autosportlabs/MegajoltC/Readme.md

Megajolt/C hardware and firmware

Project is incomplete. No support offered - github issues will be ignored. 

Please see LICENSE file for license details
