autosportlabs/MegajoltC/hardware/trunk/mjc_pinmux.xls

Megajolt/C Pinmux
Groups | MJ Function | XMC Pin# | XMC Pin Name | XMC Pin Function
Coils
 | GPO_COIL1 |  | P0.0 | GPIO
 | GPO_COIL2 |  | P0.1 | GPIO
 | GPO_COIL3 |  | P0.2 | GPIO
 | GPO_COIL4 |  | P0.3 | GPIO
 | GPO_COIL5 |  | P0.4 | GPIO
 | GPO_COIL6 |  | P0.5 | GPIO
 | GPO_COIL7 |  | P0.6 | GPIO
 | GPO_COIL8 |  | P0.7 | GPIO
 | GPO_COIL_EN |  | P0.8 | GPIO
ADC Inputs
 | CLT_ADC |  | P14.0 | VADC_G0CH0
 | IAT_ADC |  | P14.4 | VADC_G0CH4
 | TPS_ADC |  | P14.5 | VADC_G0CH5
 | VBATT_ADC |  | P14.6 | VADC_G0CH6
 | AUX_ADC
Communication
 | FTDI_TXD |  | P1.4 | U0C0.DX0B
 | FTDI_RXD |  | P1.5 | U0C0.DOUT0
 | ESP_TXD |  | P2.5 | U0C1.DOUT0
 | ESP_RXD |  | P2.2 | U0C1.DX0A
 | CAN_TX |  | P2.7 | CAN.N1_TXDC1
 | CAN_RX |  | P2.6 | CAN.N1_RXDCA1
 | EEPROM_SDA |  | P0.4 | U1C0.DX0A
 | EEPROM_SCL |  | P0.11 | U1C0_SCLKOUT
Misc Outputs
 | PGM_GPO |  | P2.3 | GPIO
 | TACH_GPO |  | P2.4 | GPIO
 | STATUS_LED1 |  | P14.8 | GPIO
 | STATUS_LED2 |  | P14.9 | GPIO
