autosportlabs/MegajoltC/tools/trigger_wheel_rotary_simulator/trigger_wheel.stl

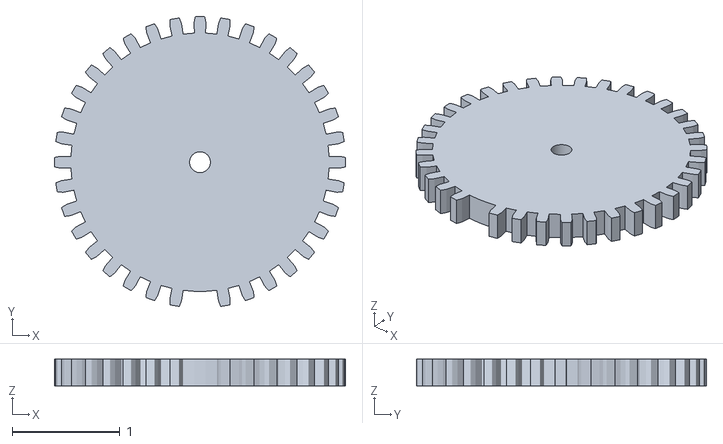
[picture p1: CAD file, 2012-10-20]
tools/trigger_wheel_rotary_simulator/trigger_wheel.stl
2.70 x 2.69 x 0.25
