autosportlabs/MegajoltC/tools/trigger_wheel_rotary_simulator/trigger_wheel_plate.stl

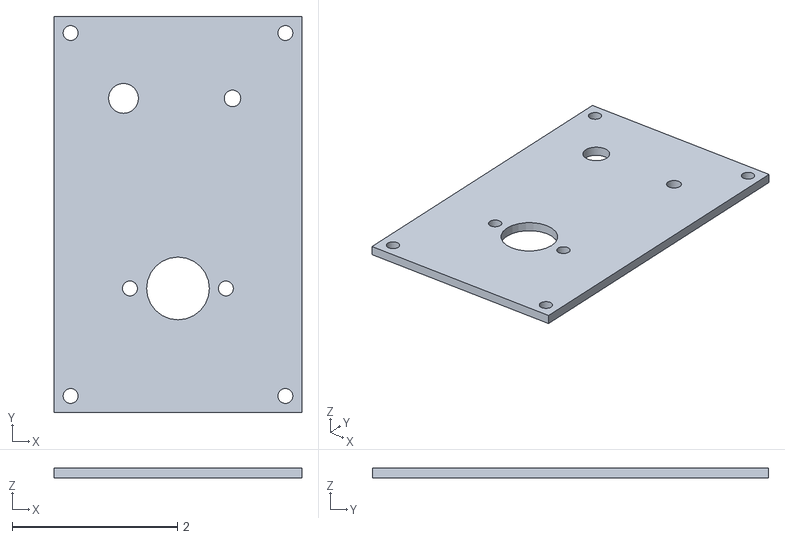
[picture p2: CAD file, 2012-10-20]
tools/trigger_wheel_rotary_simulator/trigger_wheel_plate.stl
3.00 x 4.79 x 0.125
