autosportlabs/MegajoltC/(list of files, cad)

Other CAD files:
tools/trigger_wheel_rotary_simulator/trigger_wheel.skp
tools/trigger_wheel_rotary_simulator/trigger_wheel_plate.skp
