autosportlabs/MegajoltC/hardware/trunk/megajoltC.brd

## EAGLE design hardware/trunk/megajoltC.brd (2015-04-11)

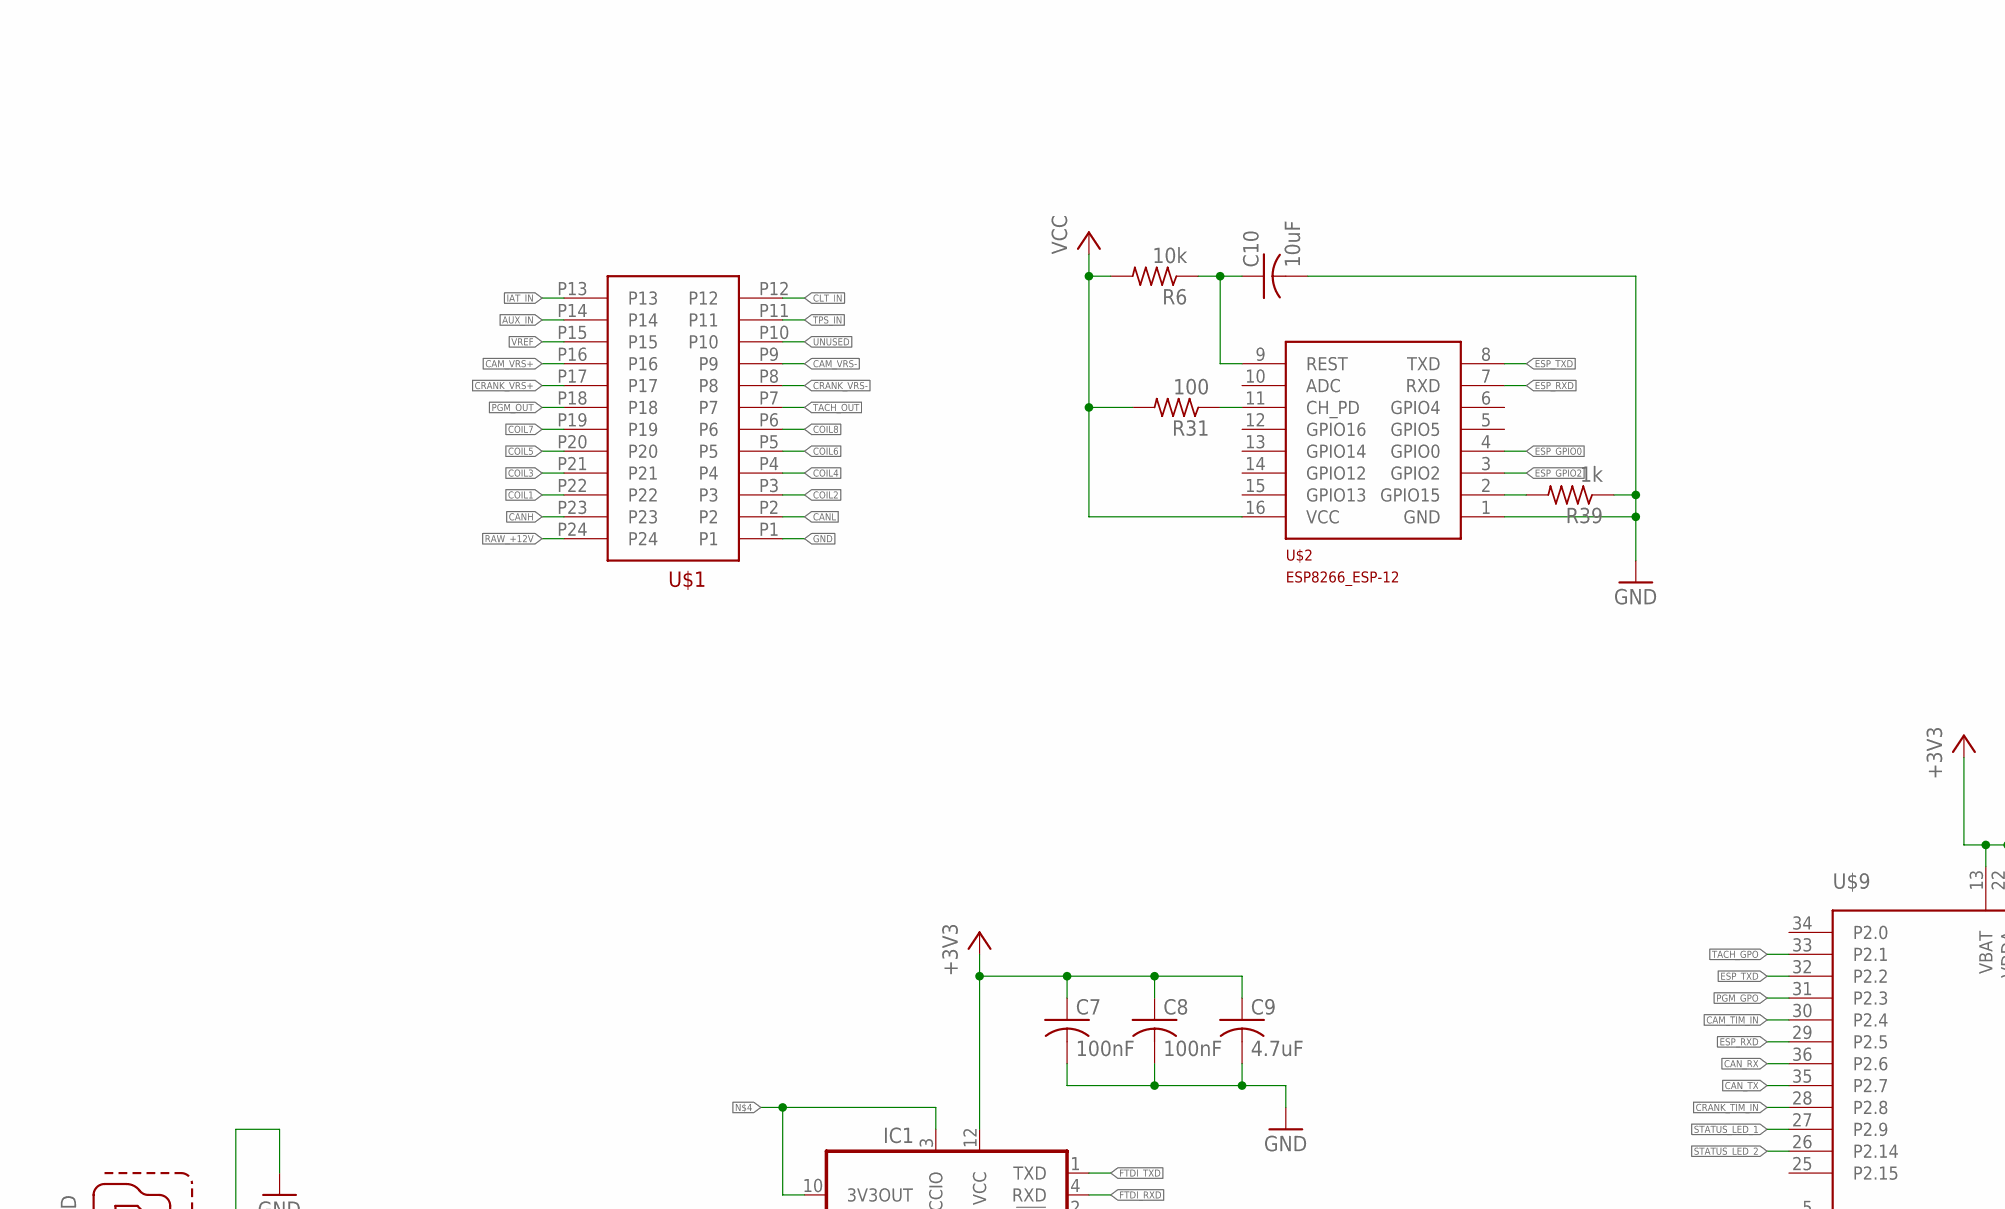
[picture p3: schematic megajoltC.sch, sheet 1, part in row 1, column 1]

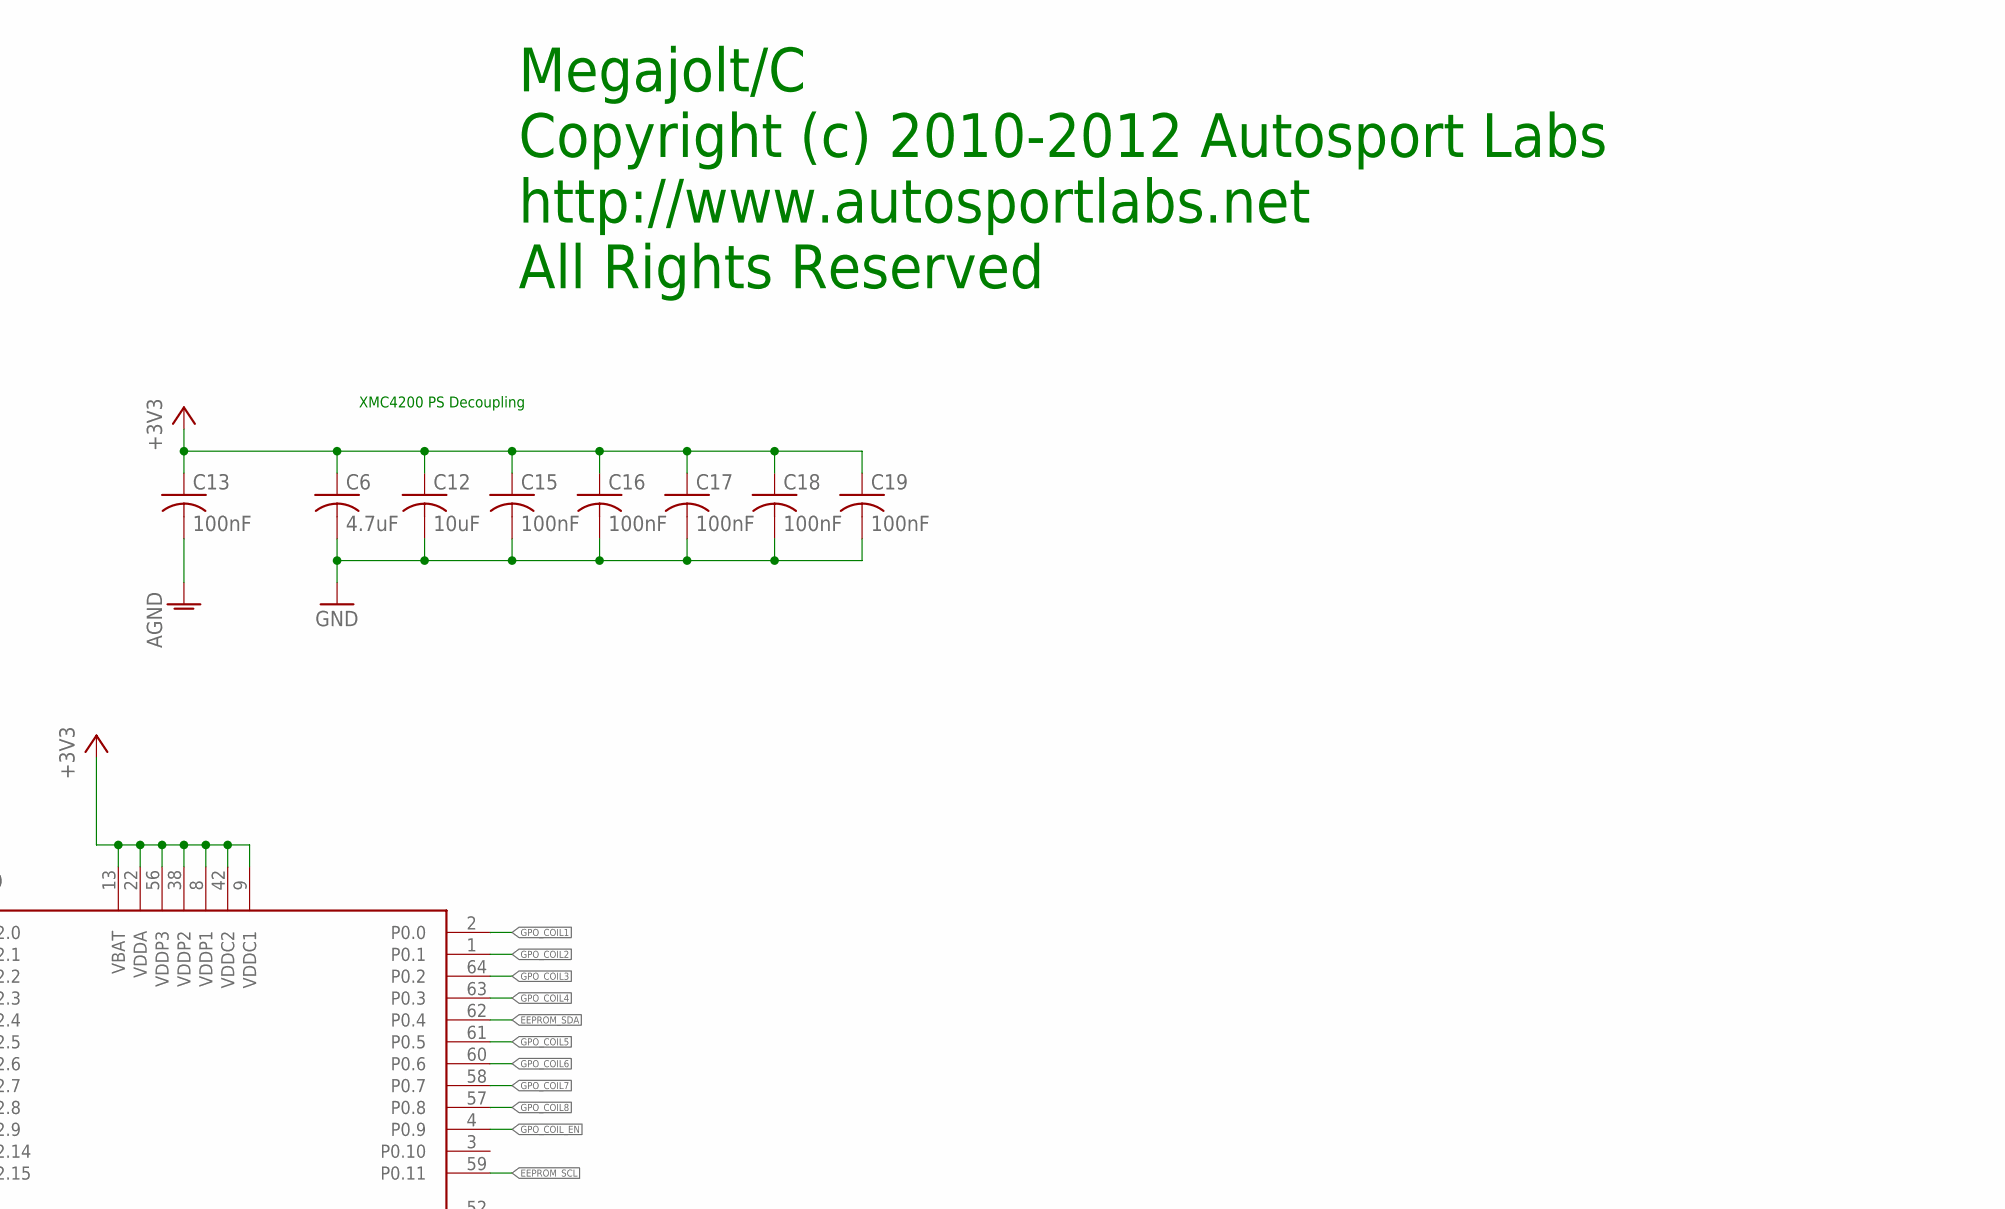
[picture p4: schematic megajoltC.sch, sheet 1, part in row 1, column 2]

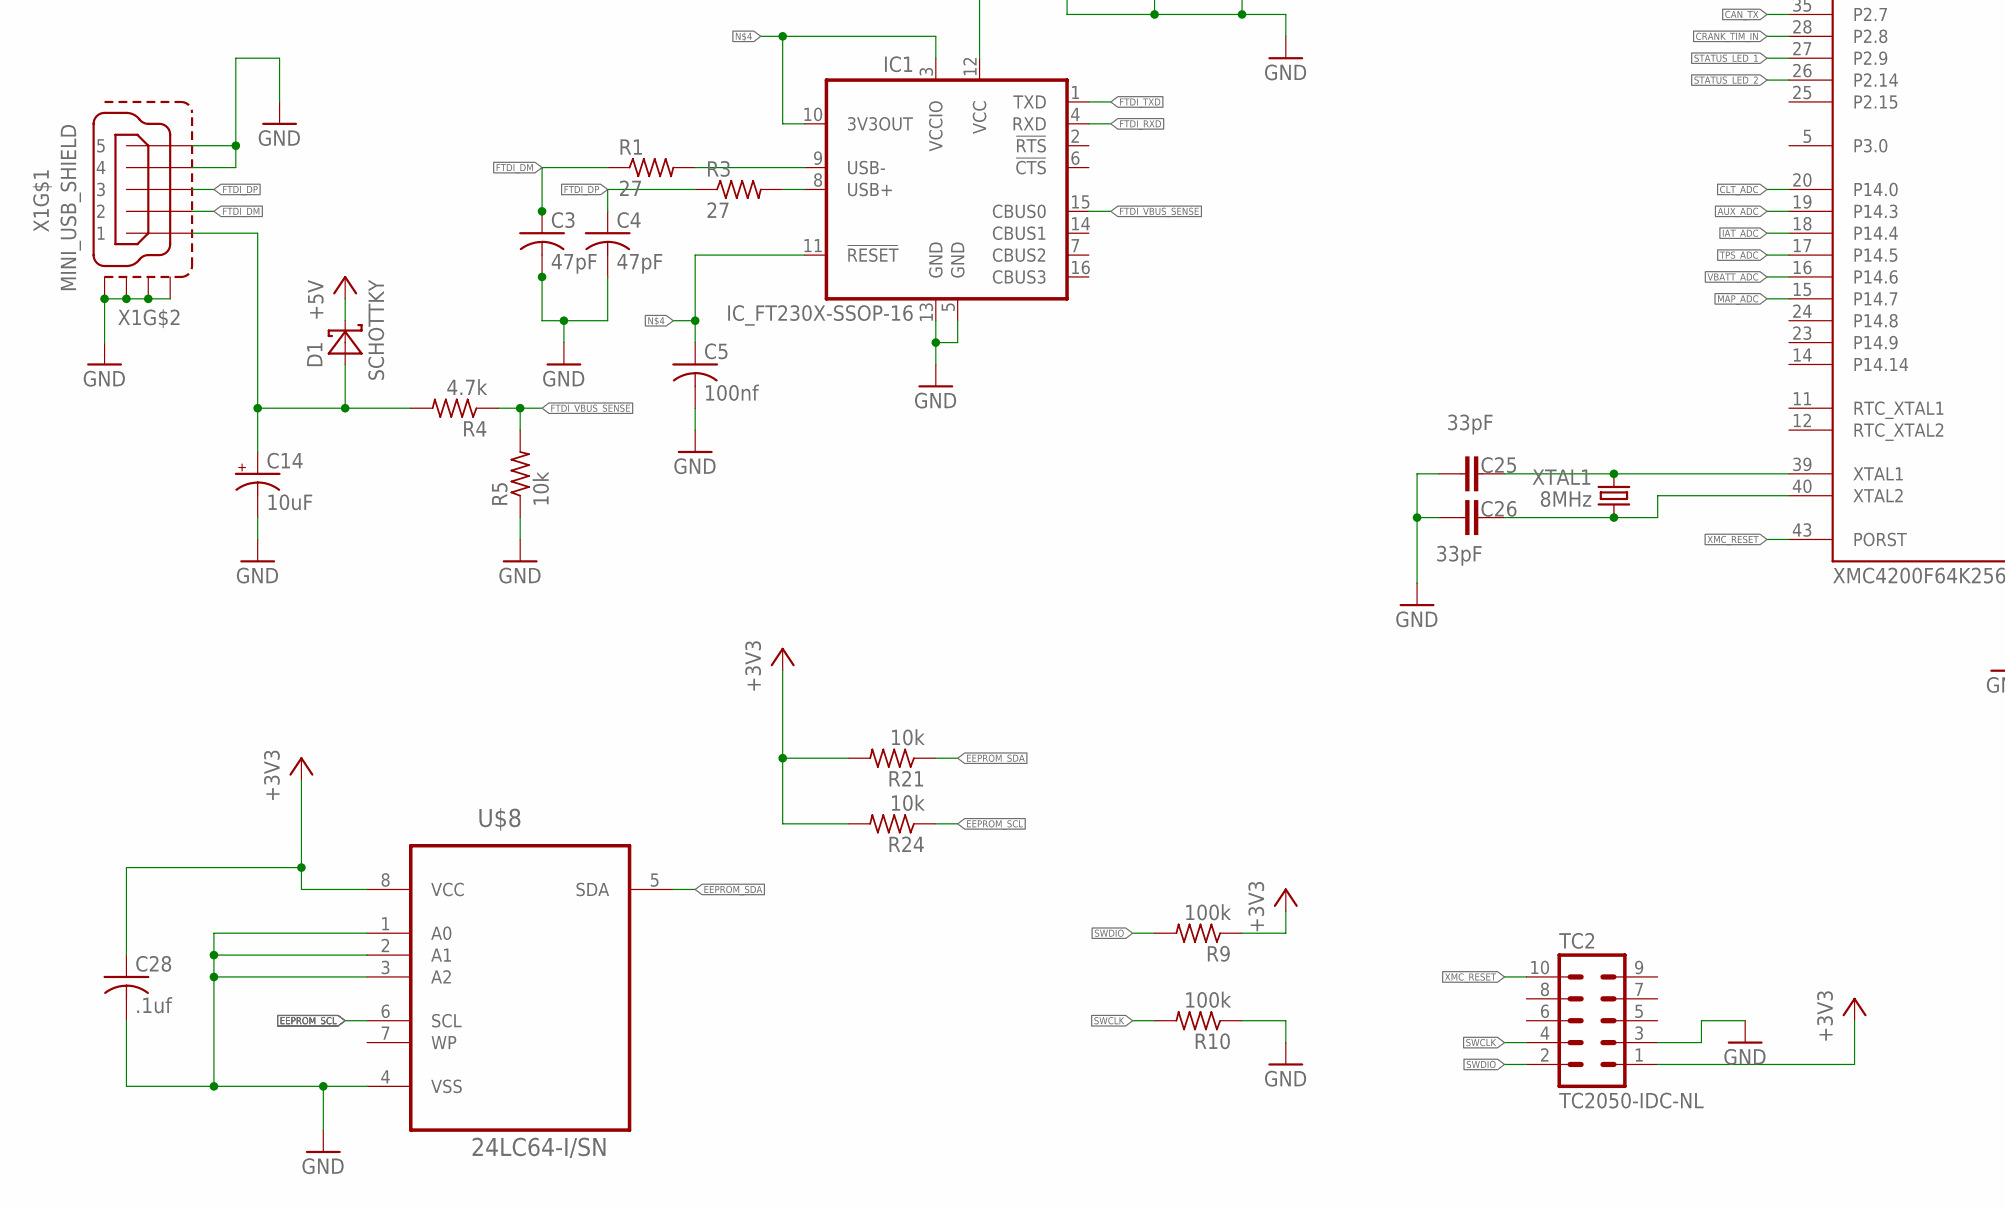
[picture p5: schematic megajoltC.sch, sheet 1, part in row 2, column 1]

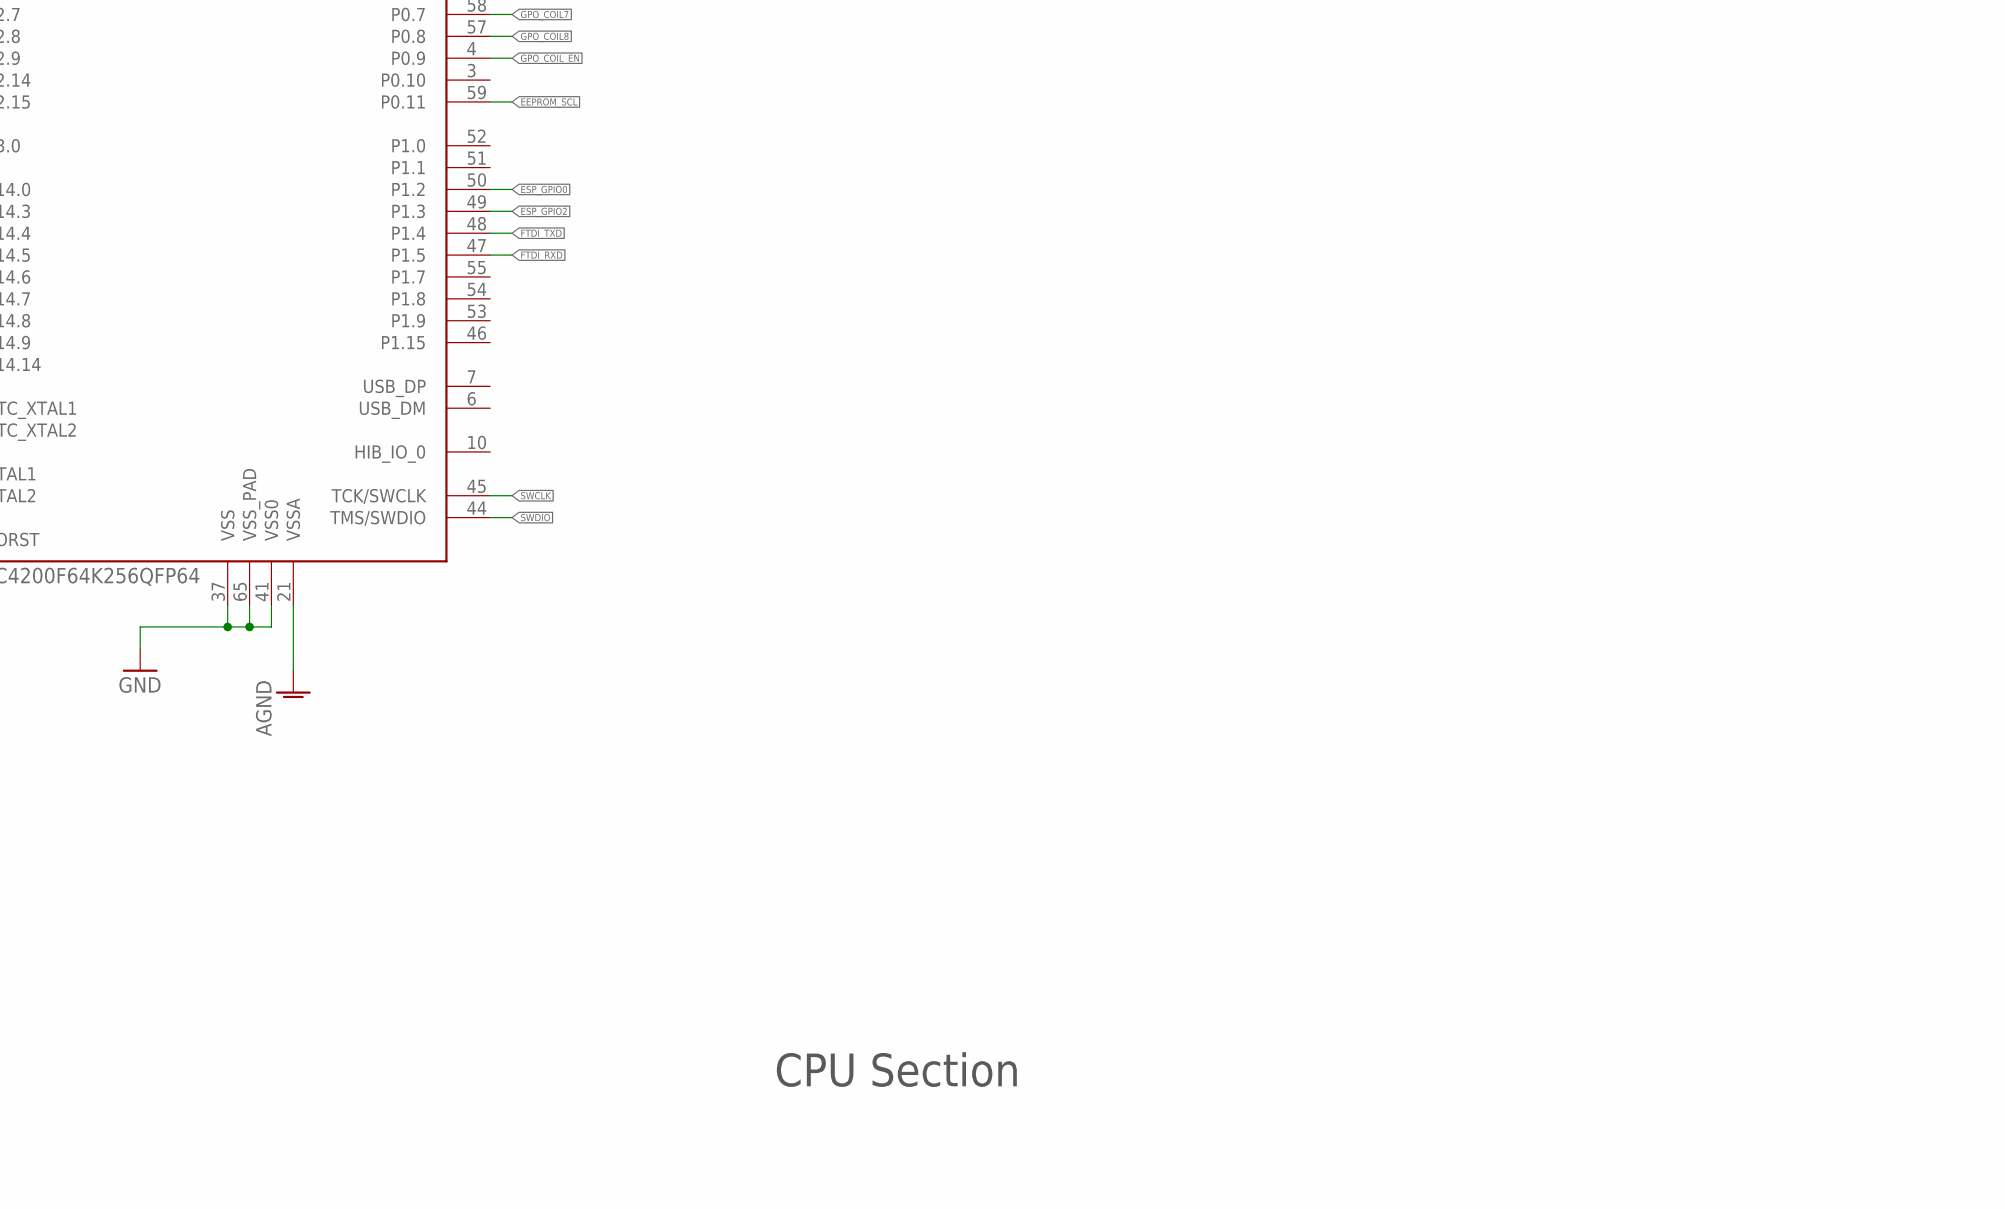
[picture p6: schematic megajoltC.sch, sheet 1, part in row 2, column 2]

Parts:
C3, C4: 47pF; C0603
C5: 100nf; C0603
C6, C9: 4.7uF; C0603
C7, C8, C13, C15, C16, C17, C18, C19: 100nF; C0603
C10, C12: 10uF; C0603
C14: 10uF; SMC_A
C25, C26: 33pF; 0603
C28: .1uf; C0603
D1: SCHOTTKY; SMA
IC1: IC_FT230X-SSOP-16; SSOP-16-FTDI
R1, R3: 27; R0603
R4: 4.7k; R0603
R5, R6, R21, R24: 10k; R0603
R9, R10: 100k; R0603
R31: 100; R0603
R39: 1k; R0603
TC2: TC2050-IDC-NL
U$1: MOLEX_MINIFIT-JR-24
U$2: ESP8266_ESP-12; ESP8266-ESP12
U$8: 24LC64-I/SN; SOIC127P600X175-8N
U$9: XMC4200F64K256QFP64; INF-PG-LQFP-64-5800X5800T28
X1: MINI_USB_SHIELD; MINI-USB_JACK
XTAL1: 8MHz; CRYSTAL-SMD-5X3

Connections:
+3V3: C6.1, C7.1, C8.1, C9.1, C12.1, C13.1, C15.1, C16.1, C17.1, C18.1, C19.1, C28.1, IC1.12 (VCC), R9.1, R21.2, R24.2, TC2.1, U$8.8 (VCC), U$9.8 (VDDP1), U$9.9 (VDDC1), U$9.13 (VBAT), U$9.22 (VDDA), U$9.38 (VDDP2), U$9.42 (VDDC2), U$9.56 (VDDP3); also elsewhere on the board
+5V: D1.C; also elsewhere on the board
AGND: C13.2, U$9.21 (VSSA); also elsewhere on the board
AUX_ADC: U$9.19 (P14.3); also elsewhere on the board
AUX_IN: U$1.P14; also elsewhere on the board
CAM_TIM_IN: U$9.30 (P2.4); also elsewhere on the board
CAM_VRS+: U$1.P16; also elsewhere on the board
CAM_VRS-: U$1.P9; also elsewhere on the board
CANH: U$1.P23; also elsewhere on the board
CANL: U$1.P2; also elsewhere on the board
CAN_RX: U$9.36 (P2.6); also elsewhere on the board
CAN_TX: U$9.35 (P2.7); also elsewhere on the board
CLT_ADC: U$9.20 (P14.0); also elsewhere on the board
CLT_IN: U$1.P12; also elsewhere on the board
COIL1: U$1.P22; also elsewhere on the board
COIL2: U$1.P3; also elsewhere on the board
COIL3: U$1.P21; also elsewhere on the board
COIL4: U$1.P4; also elsewhere on the board
COIL5: U$1.P20; also elsewhere on the board
COIL6: U$1.P5; also elsewhere on the board
COIL7: U$1.P19; also elsewhere on the board
COIL8: U$1.P6; also elsewhere on the board
CRANK_TIM_IN: U$9.28 (P2.8); also elsewhere on the board
CRANK_VRS+: U$1.P17; also elsewhere on the board
CRANK_VRS-: U$1.P8; also elsewhere on the board
EEPROM_SCL: R24.1, U$8.6 (SCL), U$9.59 (P0.11)
EEPROM_SDA: R21.1, U$8.5 (SDA), U$9.62 (P0.4)
ESP_GPIO0: U$2.4 (GPIO0), U$9.50 (P1.2)
ESP_GPIO2: U$2.3 (GPIO2), U$9.49 (P1.3)
ESP_RXD: U$2.7 (RXD), U$9.29 (P2.5)
ESP_TXD: U$2.8 (TXD), U$9.32 (P2.2)
FTDI_DM: C3.1, R1.1, X1.2
FTDI_DP: C4.1, R3.1, X1.3
FTDI_RXD: IC1.4 (RXD), U$9.47 (P1.5)
FTDI_TXD: IC1.1 (TXD), U$9.48 (P1.4)
FTDI_VBUS_SENSE: IC1.15 (CBUS0), R4.1, R5.2
GND: C3.2, C4.2, C5.2, C6.2, C7.2, C8.2, C9.2, C10.2, C12.2, C14.-, C15.2, C16.2, C17.2, C18.2, C19.2, C25.1, C26.1, C28.2, IC1.5 (GND), IC1.13 (GND), R5.1, R10.1, R39.1, TC2.3, U$1.P1, U$2.1 (GND), U$8.1 (A0), U$8.2 (A1), U$8.3 (A2), U$8.4 (VSS), U$9.37 (VSS), U$9.41 (VSS0), U$9.65 (VSS_PAD), X1.4, X1.5, X1.M1 (S1), X1.M2 (S2), X1.M3 (S3), X1.M4 (S4); also elsewhere on the board
GPO_COIL1: U$9.2 (P0.0); also elsewhere on the board
GPO_COIL2: U$9.1 (P0.1); also elsewhere on the board
GPO_COIL3: U$9.64 (P0.2); also elsewhere on the board
GPO_COIL4: U$9.63 (P0.3); also elsewhere on the board
GPO_COIL5: U$9.61 (P0.5); also elsewhere on the board
GPO_COIL6: U$9.60 (P0.6); also elsewhere on the board
GPO_COIL7: U$9.58 (P0.7); also elsewhere on the board
GPO_COIL8: U$9.57 (P0.8); also elsewhere on the board
GPO_COIL_EN: U$9.4 (P0.9); also elsewhere on the board
IAT_ADC: U$9.18 (P14.4); also elsewhere on the board
IAT_IN: U$1.P13; also elsewhere on the board
MAP_ADC: U$9.15 (P14.7); also elsewhere on the board
unnamed: IC1.8 (USB+), R3.2
unnamed: IC1.9 (USB-), R1.2
unnamed: C5.1, IC1.3 (VCCIO), IC1.10 (3V3OUT), IC1.11 (!RESET)
unnamed: C10.1, R6.1, U$2.9 (REST)
unnamed: R31.1, U$2.11 (CH_PD)
unnamed: C26.2, U$9.40 (XTAL2), XTAL1.1
unnamed: R39.2, U$2.2 (GPIO15)
unnamed: C25.2, U$9.39 (XTAL1), XTAL1.3 (2)
PGM_GPO: U$9.31 (P2.3); also elsewhere on the board
PGM_OUT: U$1.P18; also elsewhere on the board
RAW_+12V: U$1.P24; also elsewhere on the board
STATUS_LED_1: U$9.27 (P2.9); also elsewhere on the board
STATUS_LED_2: U$9.26 (P2.14); also elsewhere on the board
SWCLK: R10.2, TC2.4, U$9.45 (TCK/SWCLK)
SWDIO: R9.2, TC2.2, U$9.44 (TMS/SWDIO)
TACH_GPO: U$9.33 (P2.1); also elsewhere on the board
TACH_OUT: U$1.P7; also elsewhere on the board
TPS_ADC: U$9.17 (P14.5); also elsewhere on the board
TPS_IN: U$1.P11; also elsewhere on the board
UNUSED: U$1.P10
VBATT_ADC: U$9.16 (P14.6); also elsewhere on the board
VBUS: C14.+, D1.A, R4.2, X1.1
VCC: R6.2, R31.2, U$2.16 (VCC); also elsewhere on the board
VREF: U$1.P15; also elsewhere on the board
XMC_RESET: TC2.10, U$9.43 (PORST)

Notes on the sheet:
Megajolt/C
Copyright (c) 2010-2012 Autosport Labs
http://www.autosportlabs.net
All Rights Reserved
CPU Section
XMC4200 PS Decoupling

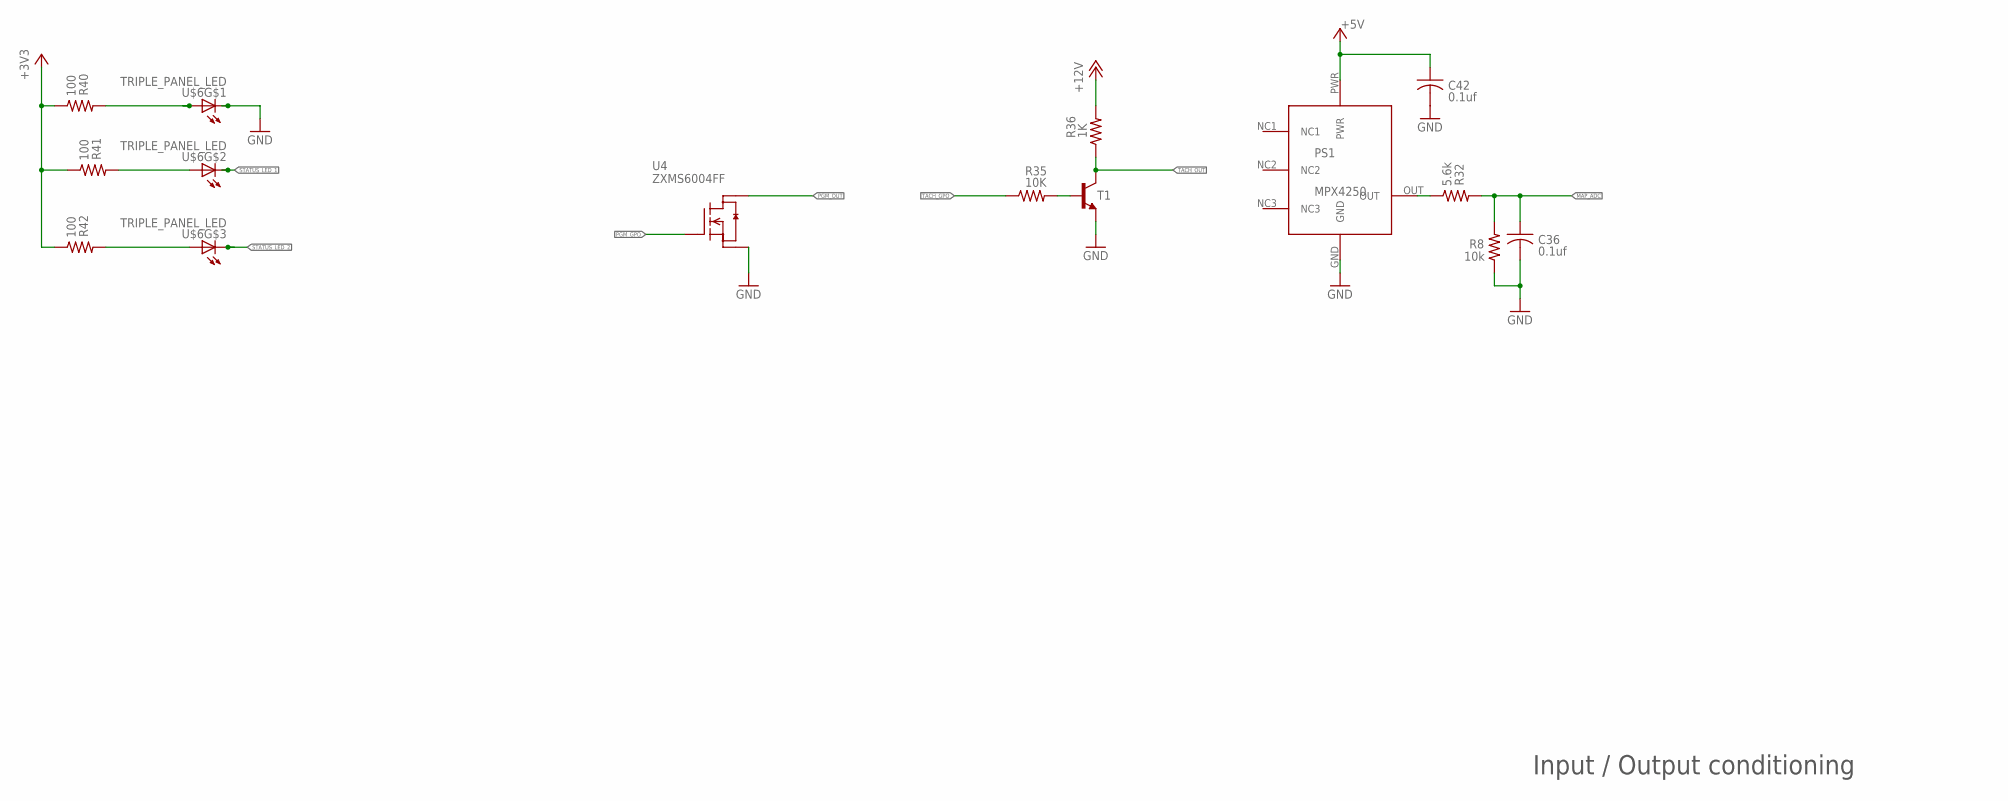
[picture p7: schematic megajoltC.sch, sheet 2]

Parts:
C36, C42: 0.1uf; C0603
PS1: MPX4250
R8: 10k; R0603
R32: 5.6k; R0603
R35: 10K; R0603
R36: 1K; R0603
R40, R41, R42: 100; R0603
T1: -NPN-SOT23-EBC; SOT23-EBC
U4: ZXMS6004FF; SOT-23
U$6: TRIPLE_PANEL_LED; RIGHT_ANGLE_3_LEDS_DEEP

Connections:
+3V3: R40.1, R41.1, R42.1; also elsewhere on the board
+5V: C42.1, PS1.PWR; also elsewhere on the board
GND: C36.2, C42.2, PS1.GND, R8.1, T1.E, U4.2 (S1), U$6.2 (C); also elsewhere on the board
MAP_ADC: C36.1, R8.2, R32.2; also elsewhere on the board
unnamed: PS1.OUT, R32.1
unnamed: R35.2, T1.B
unnamed: R40.2, U$6.1 (A)
unnamed: R41.2, U$6.3 (A)
unnamed: R42.2, U$6.5 (A)
NC1: PS1.NC1
NC2: PS1.NC2
NC3: PS1.NC3
PGM_GPO: U4.1 (G); also elsewhere on the board
PGM_OUT: U4.3 (D1); also elsewhere on the board
SAFE_+12V: R36.2; also elsewhere on the board
STATUS_LED_1: U$6.4 (C); also elsewhere on the board
STATUS_LED_2: U$6.6 (C); also elsewhere on the board
TACH_GPO: R35.1; also elsewhere on the board
TACH_OUT: R36.1, T1.C; also elsewhere on the board

Notes on the sheet:
Input / Output conditioning

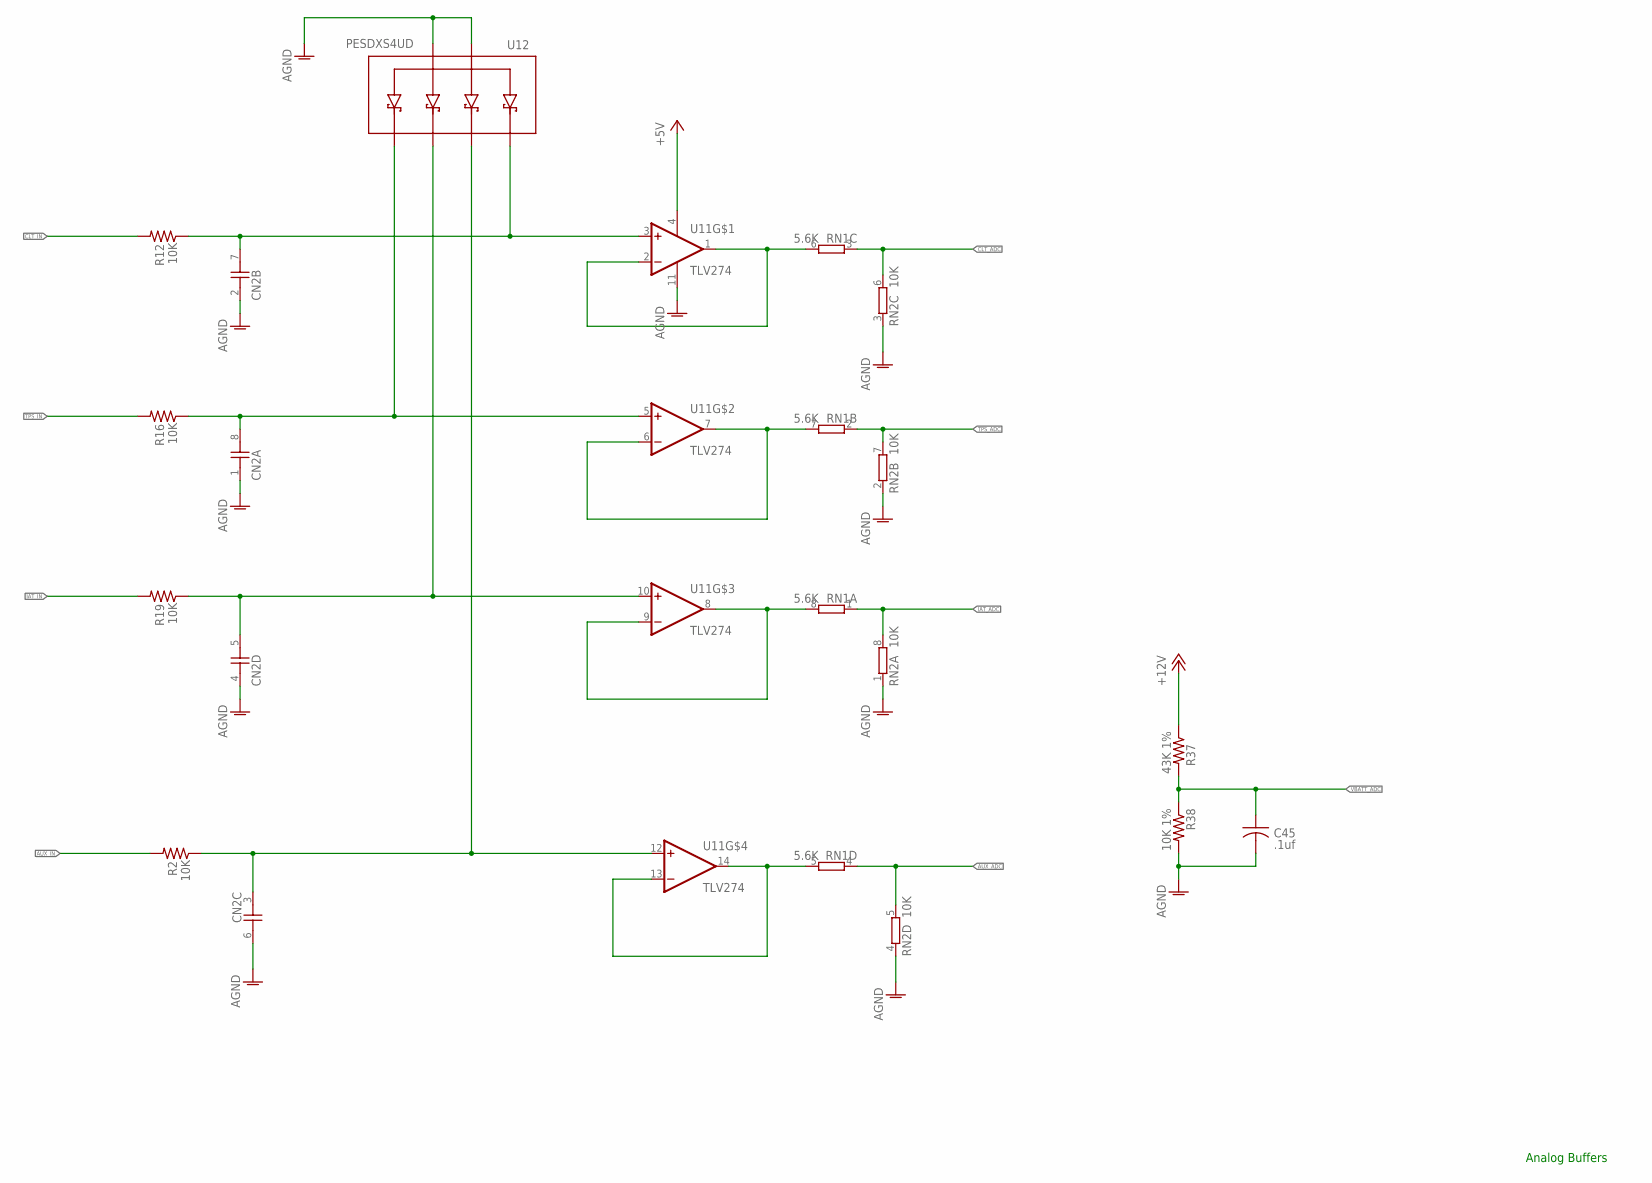
[picture p8: schematic megajoltC.sch, sheet 3]

Parts:
C45: .1uf; C0603
CN2: CAP_ARRAY_41206_ARRAY; 1206_ARRAY
R2, R12, R16, R19: 10K; R1206
R37: 43K 1%; R0603
R38: 10K 1%; R0603
RN1: 5.6K; 0603-ARC
RN2: 10K; 0603-ARC
U11: TLV274; SO14
U12: PESDXS4UD; SC-74

Connections:
+5V: U11.4 (V+); also elsewhere on the board
AGND: C45.2, CN2.1, CN2.2 (1), CN2.4 (1), CN2.6 (2), R38.2, RN2.1, RN2.2 (1), RN2.3 (1), RN2.4 (1), U11.11 (V-), U12.2, U12.5; also elsewhere on the board
ANALOG-FREQ_1_OPAMP_OUT1: RN1.6 (2), U11.1 (OUT), U11.2 (-IN)
ANALOG-FREQ_1_OPAMP_OUT2: RN1.7 (2), U11.6 (-IN), U11.7 (OUT)
ANALOG-FREQ_1_OPAMP_OUT3: RN1.8 (2), U11.8 (OUT), U11.9 (-IN)
AUX_ADC: RN1.4 (1), RN2.5 (2); also elsewhere on the board
AUX_IN: R2.2; also elsewhere on the board
CLT_ADC: RN1.3 (1), RN2.6 (2); also elsewhere on the board
CLT_IN: R12.2; also elsewhere on the board
IAT_ADC: RN1.1, RN2.8 (2); also elsewhere on the board
IAT_IN: R19.2; also elsewhere on the board
unnamed: RN1.5 (2), U11.13 (-IN), U11.14 (OUT)
unnamed: CN2.7 (2), R12.1, U11.3 (+IN), U12.1
unnamed: CN2.8 (2), R16.1, U11.5 (+IN), U12.6
unnamed: CN2.5 (2), R19.1, U11.10 (+IN), U12.4
unnamed: CN2.3 (1), R2.1, U11.12 (+IN), U12.3
SAFE_+12V: R37.1; also elsewhere on the board
TPS_ADC: RN1.2 (1), RN2.7 (2); also elsewhere on the board
TPS_IN: R16.2; also elsewhere on the board
VBATT_ADC: C45.1, R37.2, R38.1; also elsewhere on the board

Notes on the sheet:
Analog Buffers

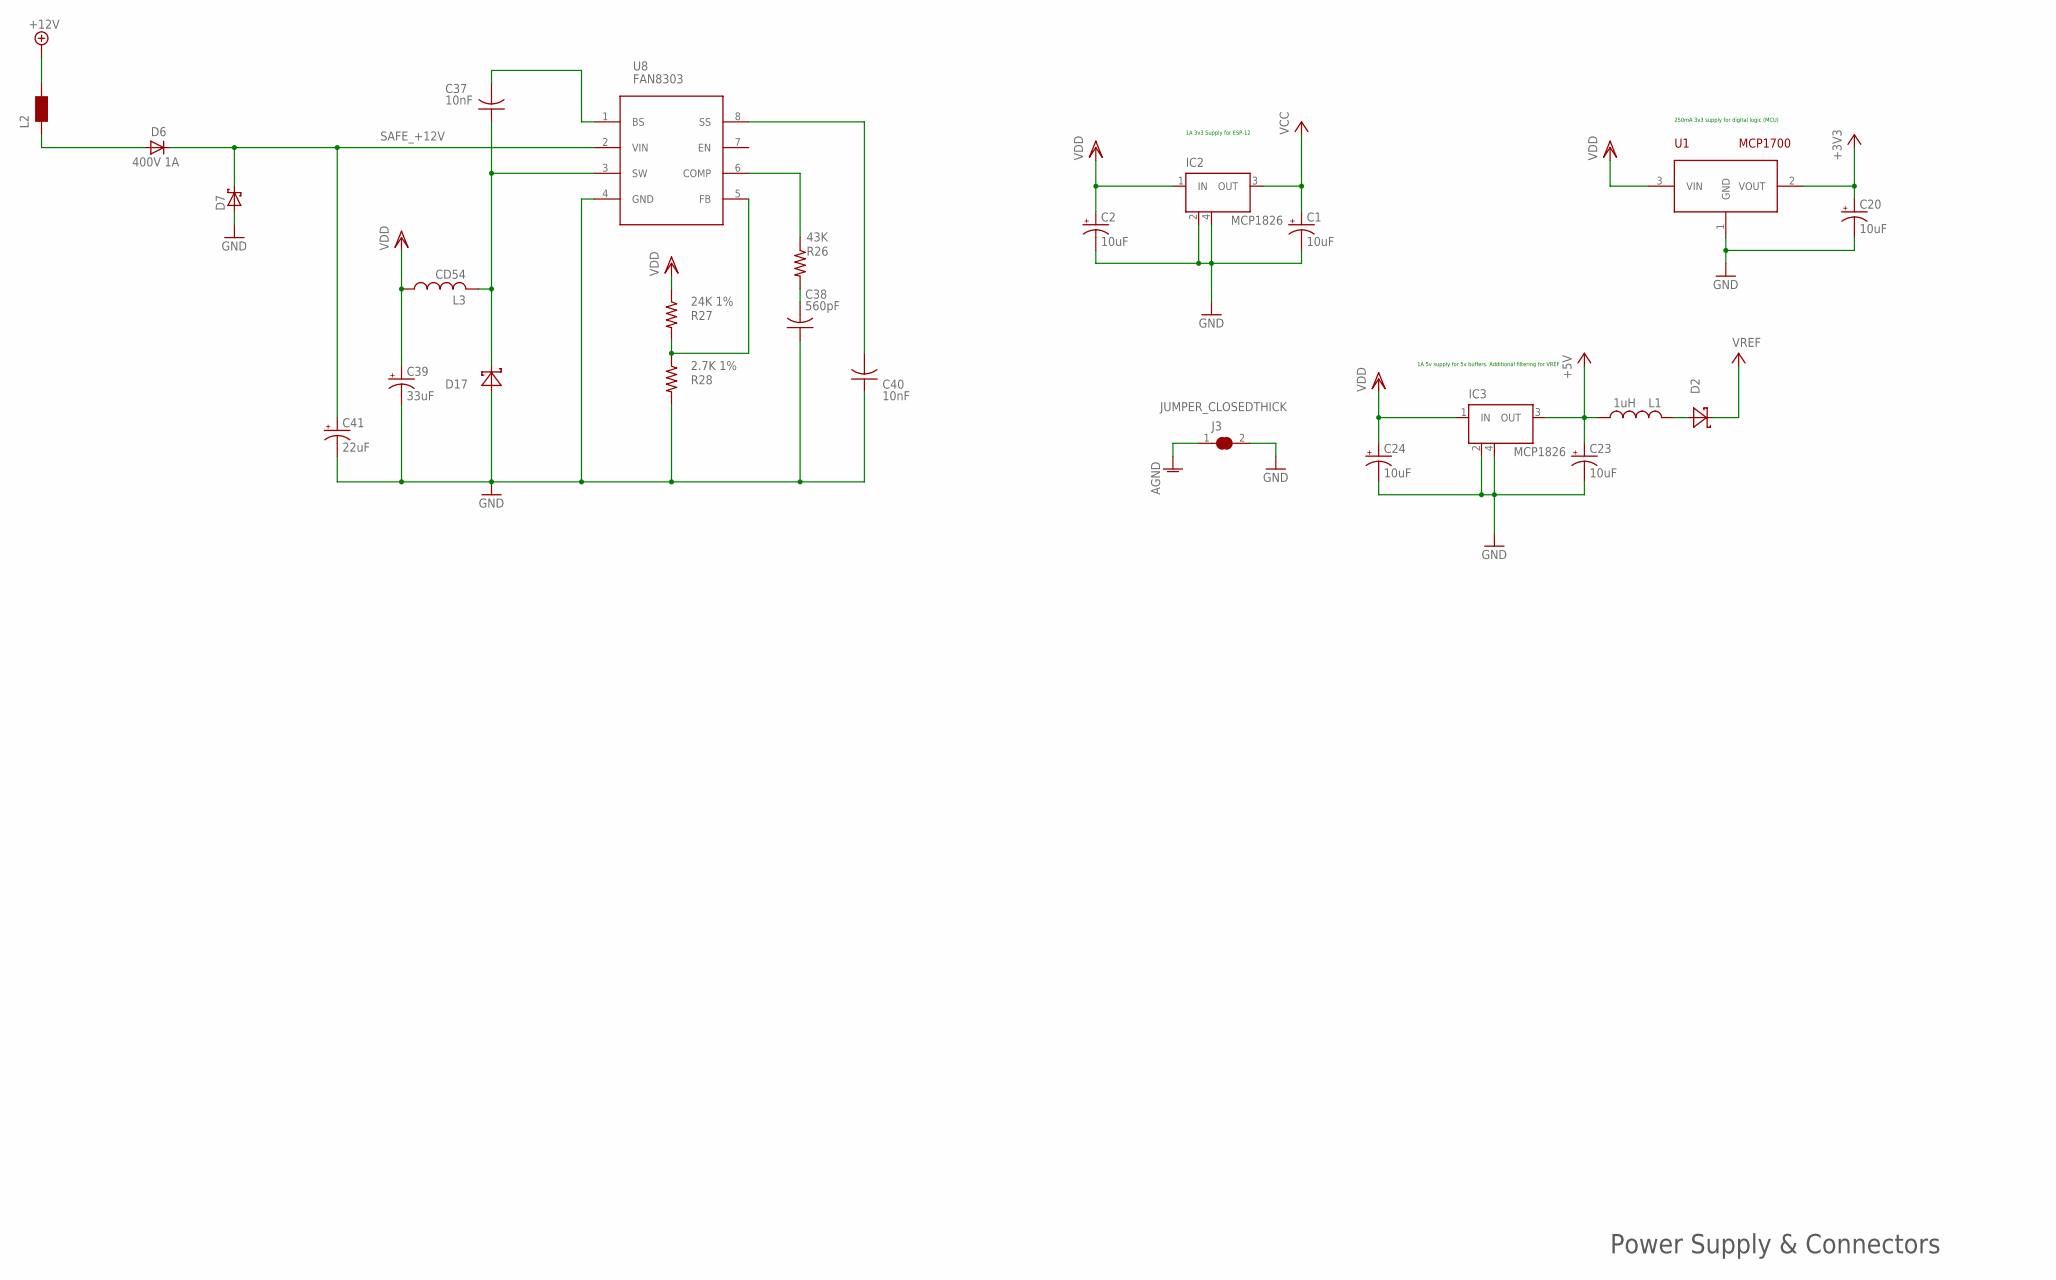
[picture p9: schematic megajoltC.sch, sheet 4]

Parts:
C1, C2, C20, C23, C24: 10uF; SMC_A
C37, C40: 10nF; C0603
C38: 560pF; C0603
C39: 33uF; SMC_D
C41: 22uF; 153CLV-0605
D2, D17: SCHOTTKY; SMA
D6: 400V 1A; SMA
D7: SCHOTTKY-DIODESMC; SMC
IC2, IC3: MCP1826; SOT223
J3: JUMPER_CLOSEDTHICK; JUMPER_CLOSED_THICK
L1: 1uH; 1210
L2: WE-CBF_1812; 1812
L3: CD54
R26: 43K; R0603
R27: 24K 1%; R0603
R28: 2.7K 1%; R0603
U1: MCP1700; SOT-23
U8: FAN8303; SO-8

Connections:
+3V3: C20.+, U1.2 (VOUT); also elsewhere on the board
+5V: C23.+, IC3.3 (OUT), L1.1; also elsewhere on the board
AGND: J3.1; also elsewhere on the board
GND: C1.-, C2.-, C20.-, C23.-, C24.-, C38.1, C39.-, C40.1, C41.-, D7.A, D17.A, IC2.2 (GND), IC2.4 (GND), IC3.2 (GND), IC3.4 (GND), J3.2, R28.2, U1.1 (GND), U8.4 (GND); also elsewhere on the board
unnamed: D2.A, L1.2
unnamed: R27.2, R28.1, U8.5 (FB)
unnamed: C37.2, U8.1 (BS)
unnamed: C37.1, D17.C, L3.P$2 (2), U8.3 (SW)
unnamed: C38.2, R26.2
unnamed: R26.1, U8.6 (COMP)
unnamed: C40.2, U8.8 (SS)
unnamed: D6.A, L2.1
RAW_+12V: L2.2; also elsewhere on the board
SAFE_+12V: C41.+, D6.C, D7.C, U8.2 (VIN); also elsewhere on the board
VCC: C1.+, IC2.3 (OUT); also elsewhere on the board
VDD: C2.+, C24.+, C39.+, IC2.1 (IN), IC3.1 (IN), L3.P$1 (1), R27.1, U1.3 (VIN)
VREF: D2.C; also elsewhere on the board

Notes on the sheet:
Power Supply & Connectors
1A 3v3 Supply for ESP-12
1A 5v supply for 5v buffers. Additional filtering for VREF
250mA 3v3 supply for digital logic (MCU)
