autosportlabs/MegajoltC/hardware/trunk/megajoltC.brd

## EAGLE design hardware/trunk/megajoltC.brd (continued)

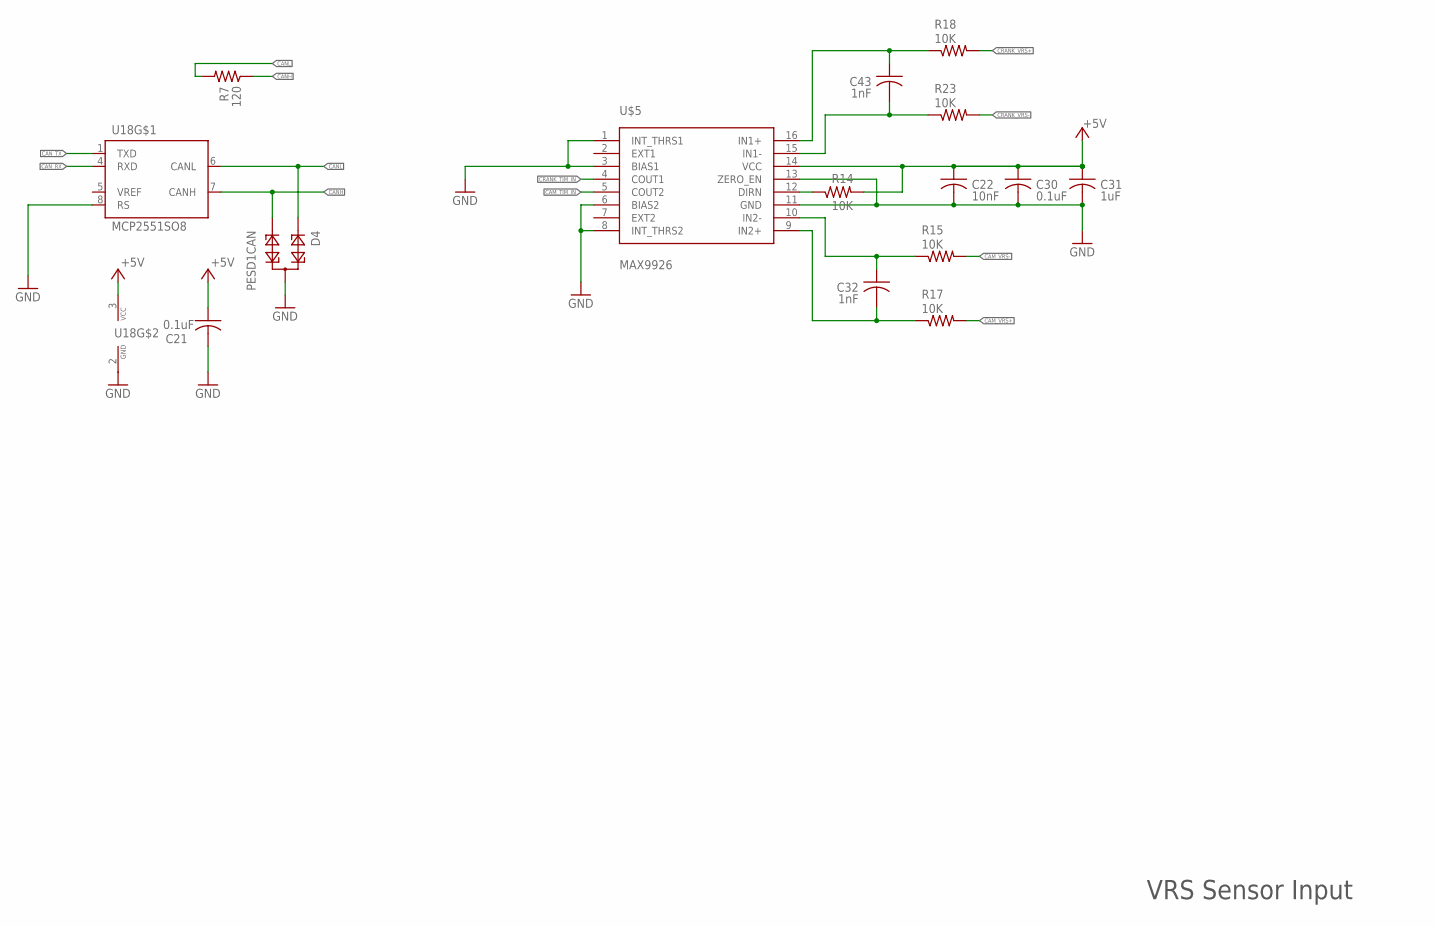
[picture p10: schematic megajoltC.sch, sheet 5]

Parts:
C21: 0.1uF; C0603K
C22: 10nF; C0603
C30: 0.1uF; C0603
C31: 1uF; C0603
C32, C43: 1nF; C0603
D4: PESD1CAN; SOT23
R7: 120; R0603
R14, R15, R17, R18, R23: 10K; R0603
U18: MCP2551SO8; SO08
U$5: MAX9926; QSOP16

Connections:
+5V: C21.1, C22.1, C30.1, C31.1, R14.2, U18.3 (VCC), U$5.14 (VCC); also elsewhere on the board
CAM_TIM_IN: U$5.5 (COUT2); also elsewhere on the board
CAM_VRS+: R17.2; also elsewhere on the board
CAM_VRS-: R15.2; also elsewhere on the board
CANH: D4.2, R7.1, U18.7 (CANH); also elsewhere on the board
CANL: D4.1, R7.2, U18.6 (CANL); also elsewhere on the board
CAN_RX: U18.4 (RXD); also elsewhere on the board
CAN_TX: U18.1 (TXD); also elsewhere on the board
CRANK_TIM_IN: U$5.4 (COUT1); also elsewhere on the board
CRANK_VRS+: R18.2; also elsewhere on the board
CRANK_VRS-: R23.2; also elsewhere on the board
GND: C21.2, C22.2, C30.2, C31.2, D4.3, U18.2 (GND), U18.8 (RS), U$5.1 (INT_THRS1), U$5.3 (BIAS1), U$5.6 (BIAS2), U$5.8 (INT_THRS2), U$5.11 (GND), U$5.13 (ZERO_EN); also elsewhere on the board
MAX_DIRN: R14.1, U$5.12 (DIRN)
unnamed: C43.1, R18.1, U$5.16 (IN1+)
unnamed: C32.1, R15.1, U$5.10 (IN2-)
unnamed: C32.2, R17.1, U$5.9 (IN2+)
unnamed: C43.2, R23.1, U$5.15 (IN1-)

Notes on the sheet:
VRS Sensor Input

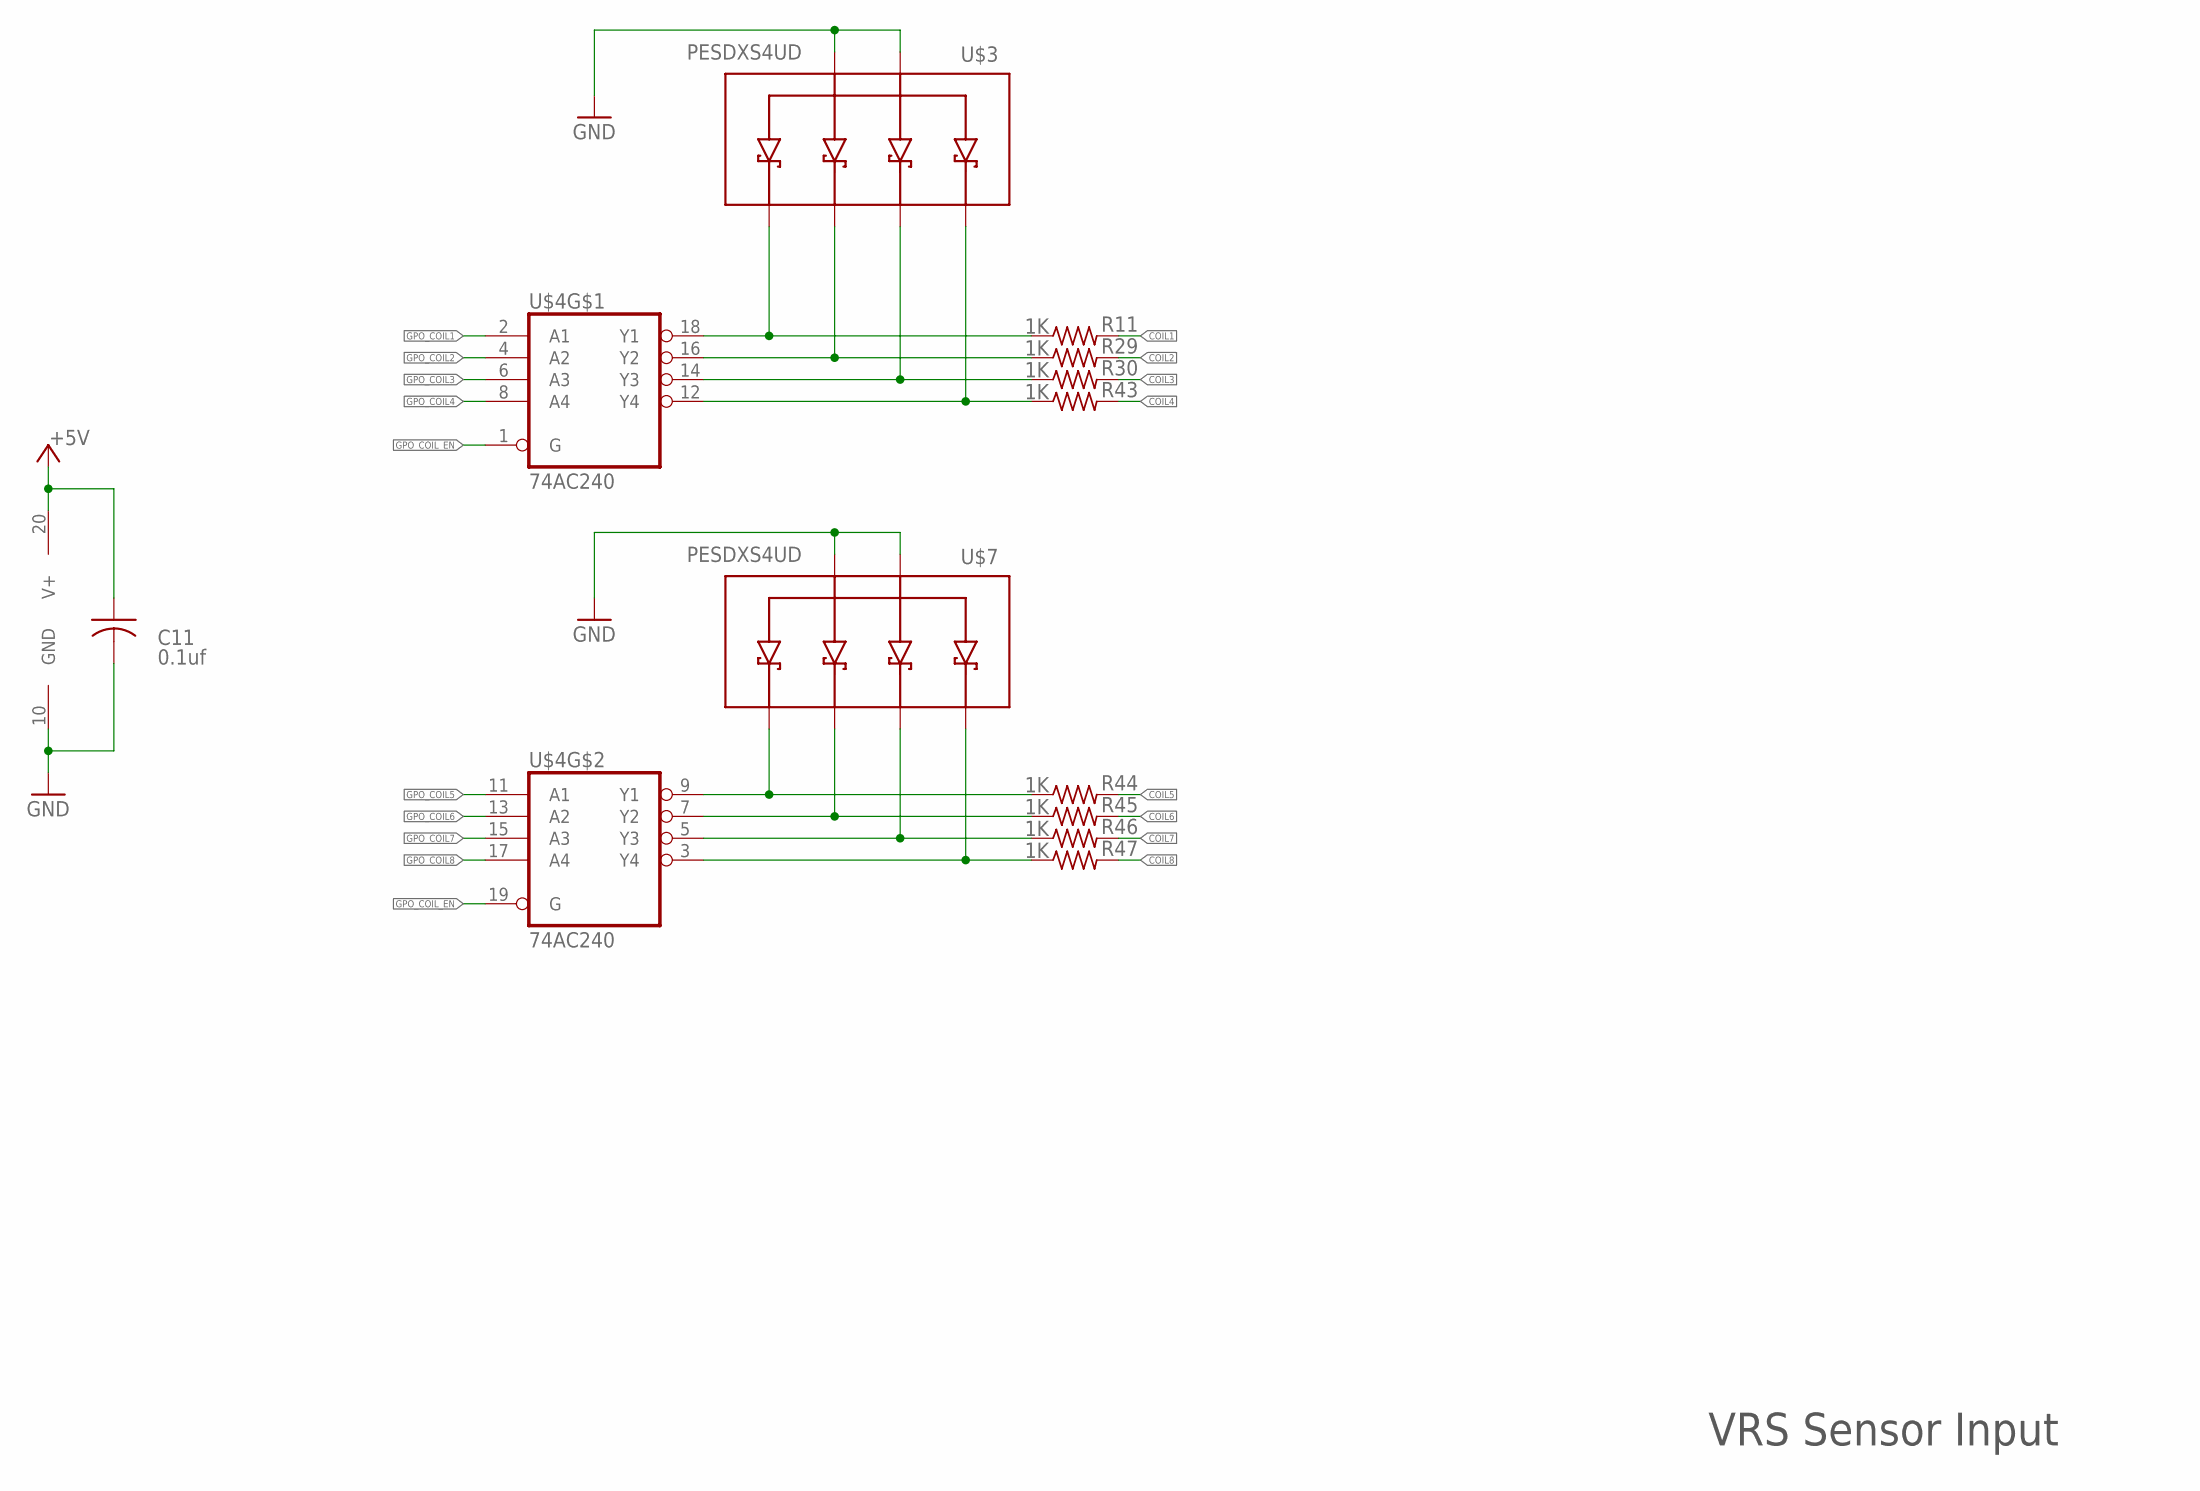
[picture p11: schematic megajoltC.sch, sheet 6]

Parts:
C11: 0.1uf; C0603
R11, R29, R30, R43, R44, R45, R46, R47: 1K; R0603
U$3, U$7: PESDXS4UD; SC-74
U$4: 74AC240; TSSOP-20

Connections:
+5V: C11.1, U$4.20 (V+); also elsewhere on the board
COIL1: R11.2; also elsewhere on the board
COIL2: R29.2; also elsewhere on the board
COIL3: R30.2; also elsewhere on the board
COIL4: R43.2; also elsewhere on the board
COIL5: R44.2; also elsewhere on the board
COIL6: R45.2; also elsewhere on the board
COIL7: R46.2; also elsewhere on the board
COIL8: R47.2; also elsewhere on the board
GND: C11.2, U$3.2, U$3.5, U$4.10 (GND), U$7.2, U$7.5; also elsewhere on the board
GPO_COIL1: U$4.2 (A1); also elsewhere on the board
GPO_COIL2: U$4.4 (A2); also elsewhere on the board
GPO_COIL3: U$4.6 (A3); also elsewhere on the board
GPO_COIL4: U$4.8 (A4); also elsewhere on the board
GPO_COIL5: U$4.11 (A1); also elsewhere on the board
GPO_COIL6: U$4.13 (A2); also elsewhere on the board
GPO_COIL7: U$4.15 (A3); also elsewhere on the board
GPO_COIL8: U$4.17 (A4); also elsewhere on the board
GPO_COIL_EN: U$4.1 (G), U$4.19 (G); also elsewhere on the board
unnamed: R11.1, U$3.6, U$4.18 (Y1)
unnamed: R29.1, U$3.4, U$4.16 (Y2)
unnamed: R30.1, U$3.3, U$4.14 (Y3)
unnamed: R43.1, U$3.1, U$4.12 (Y4)
unnamed: R44.1, U$4.9 (Y1), U$7.6
unnamed: R45.1, U$4.7 (Y2), U$7.4
unnamed: R46.1, U$4.5 (Y3), U$7.3
unnamed: R47.1, U$4.3 (Y4), U$7.1

Notes on the sheet:
VRS Sensor Input

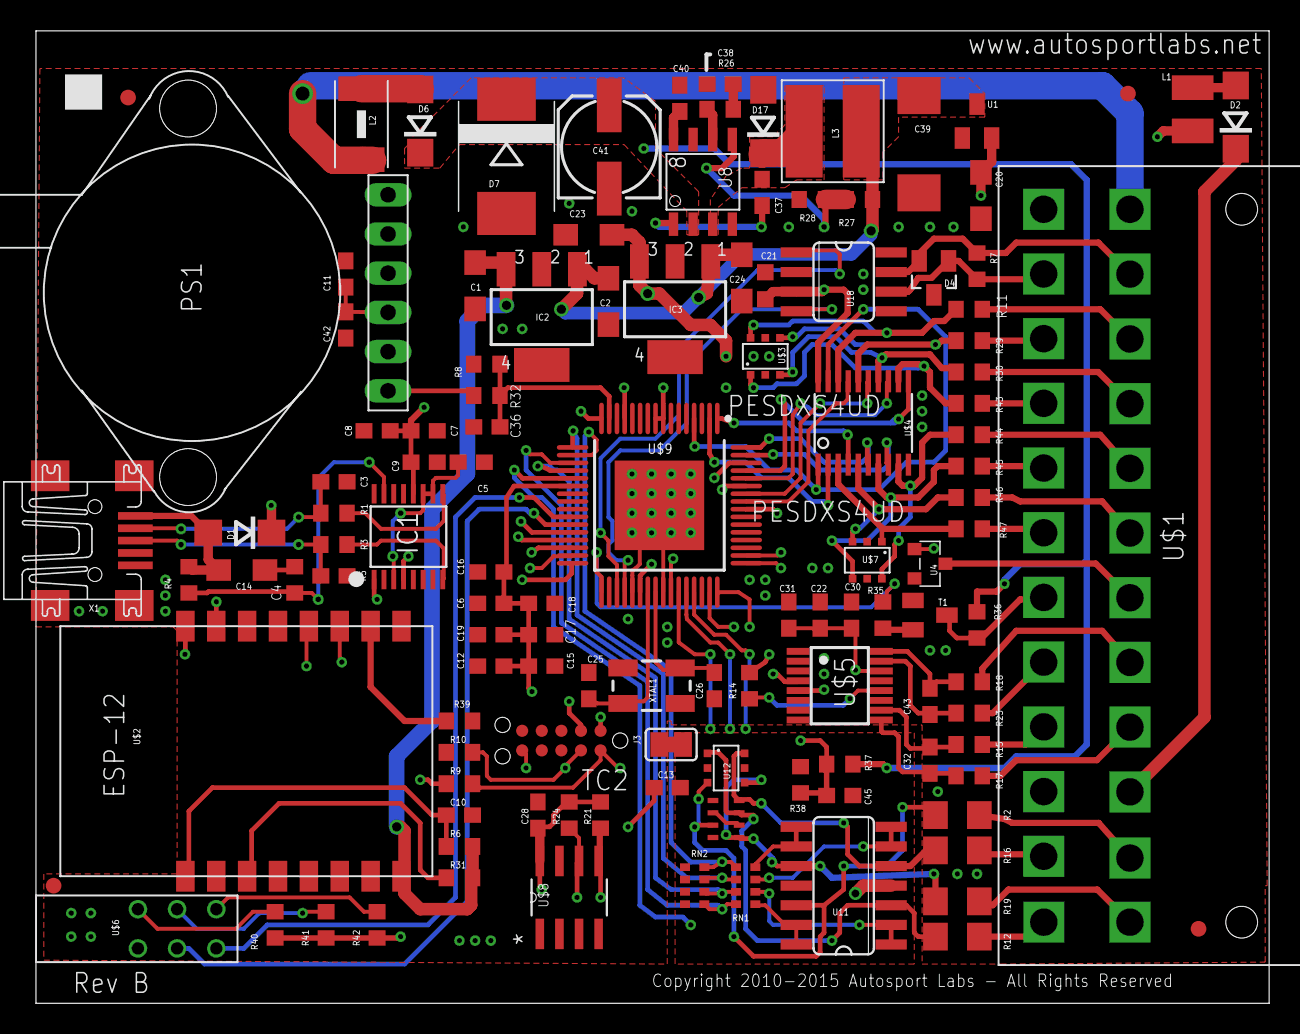
[picture p12: board megajoltC.brd from above]

Board: 4 copper layers, 79.9 x 63.0 mm, 116 parts (0 on the bottom side), 109 nets.
