autosportlabs/MegajoltC/(commit log)

2010-11-29 initial checkin of megajolt/c hardware
    [megajoltC.brd, megajoltC.sch]
2010-12-05 before adding tach_out and extra ADC
    [megajoltC.brd, megajoltC.sch]
2010-12-05 added tach_out and extra ADC
    [megajoltC.brd, megajoltC.sch]
2010-12-17 updated MegajoltC
    [megajoltC.brd]
2010-12-25 added jtag port, ugh
    [megajoltC.brd, megajoltC.sch]
2011-01-01 RevA final? I think so..
    [megajoltC.brd, megajoltC.sch]
2011-01-08 added smoothing cap to 12v ADC
    [megajoltC.brd, megajoltC.sch]
2011-03-13 RevA1 updates. whew
    [megajoltC.brd, megajoltC.sch]
2011-07-31 updates to trigger wheel isr
2011-08-30 lots of changes. debugged and fixed edge conditions and so on. good stuff
    [ignition_config.h, ignition_config_defaults.h, runtime.c, runtime.h, triggerWheelIsr.c]
2011-09-26 updates for API, adc calibration
2011-09-26 updates to reflect changes in SAM7s base framework
2011-11-12 figured out instability issue with tooth overrun
    [runtime.c, triggerWheelIsr.c]
2011-11-16 added fixed ignition advance routine and some debug commands
    [runtime.c, runtime.h]
2012-01-02 moved trigger wheel logic out of ISR and into regular code; added LED3; added code to handle disabled trace facility; disabled trace facility'
2012-09-22 added trigger wheel simulator
    [trigger_wheel_simulator.skp, trigger_wheel_simulator.stl]
2012-09-22 added 2.6 inch dia trigger wheel
    [trigger_wheel.skp, trigger_wheel.stl]
2012-09-22 renamed folder
    [trigger_wheel_simulator.skp, trigger_wheel_simulator.stl]
2012-09-22 moved cad files to new folder
    [trigger_wheel.skp, trigger_wheel.stl]
2012-09-22 added submodule for trigger wheel signal generator
2012-09-22 added SAM7s_lua submodule for trigger wheel signal generator
2012-09-22 renamed files to make more sense
    [trigger_wheel_plate.skp, trigger_wheel_plate.stl]
2012-09-27 updated trigger wheel CAD design
2012-10-09 candidate for Rev B
    [megajoltC.brd, megajoltC.sch]
2012-10-09 rev A release
    [megajoltC.brd, megajoltC.sch]
2012-10-12 updated trigger wheel plate
    [trigger_wheel_plate.skp, trigger_wheel_plate.stl]
2012-10-13 updated trigger wheel
    [trigger_wheel.skp, trigger_wheel.stl]
2012-10-18 set LED to indicate trigger wheel synchronization
2012-10-18 rev b release
    [megajoltC.brd, megajoltC.sch]
2012-10-18 added Rev_B files
    [megajoltC.brd, megajoltC.sch]
2013-06-24 added tach out toggling on charge / discharge of coil
2015-01-21 removed SAM7s; cleaned up to prep for XMC; altered power supply and vref circuit
    [megajoltC.brd, megajoltC.sch]
2015-03-21 Schematic V1 for MJ2/C
    Also added pinmux for xmc4200. Board is partially routed to assist in pinout
    [megajoltC.brd, megajoltC.sch, mjc_pinmux.xls]
2015-03-24 Schematic, second draft complete
    Also added gitignore
    [megajoltC.brd, megajoltC.sch]
2015-03-28 Board routed. V1
    [megajoltC.brd, megajoltC.sch, mjc_pinmux.xls]
2015-03-28 Fix minor grounding issue
    [megajoltC.brd]
2015-03-28 Fix DRC Dimension issue
    [megajoltC.brd]
2015-03-29 Change label size on board. Add additional gnd stitching
    [megajoltC.brd]
2015-03-29 Add Fiducial marks
    [megajoltC.brd]
2015-04-11 Slight update to routing
    [megajoltC.brd, mjc_pinmux.xls]
2015-04-11 Remove R13, minor ground pour changes
    [megajoltC.brd, megajoltC.sch]
2015-04-11 Minor layout trace changes
    [megajoltC.brd]
2015-04-11 Fix bad ground path issue
    [megajoltC.brd]
