autosportlabs/MegajoltC/(notices)

Notices in the files:
hardware/trunk/megajoltC.brd:
Copyright 2010-2015 Autosport Labs - All Rights Reserved
